zb87/esphome-comfoair/pcb/v1/PCBv1 - Top Case.stl

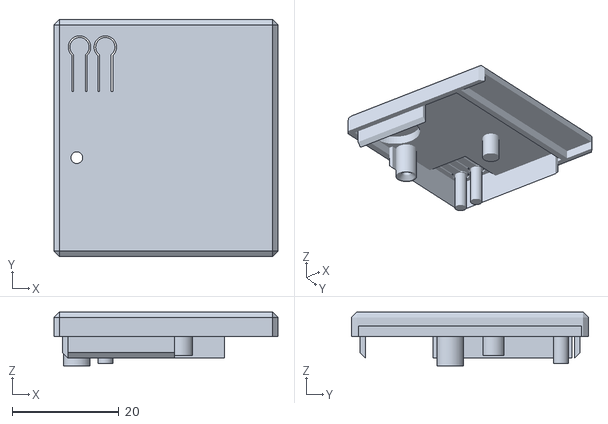
[picture p1: CAD file, 2026-07-18]
pcb/v1/PCBv1 - Top Case.stl
41.9 x 44.4 x 10.1
