zb87/esphome-comfoair/pcb/v1/PCBv1 - Bottom Case.stl

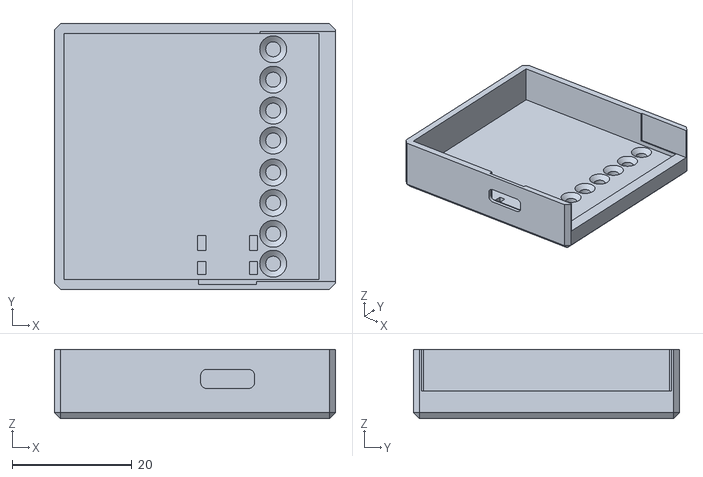
[picture p2: CAD file, 2026-07-18]
pcb/v1/PCBv1 - Bottom Case.stl
46.9 x 44.4 x 11.6
