zb87/esphome-comfoair/pcb/v1/ComfoAir_Schematic_V1.01.pdf

# ESP32 S3

# POWER

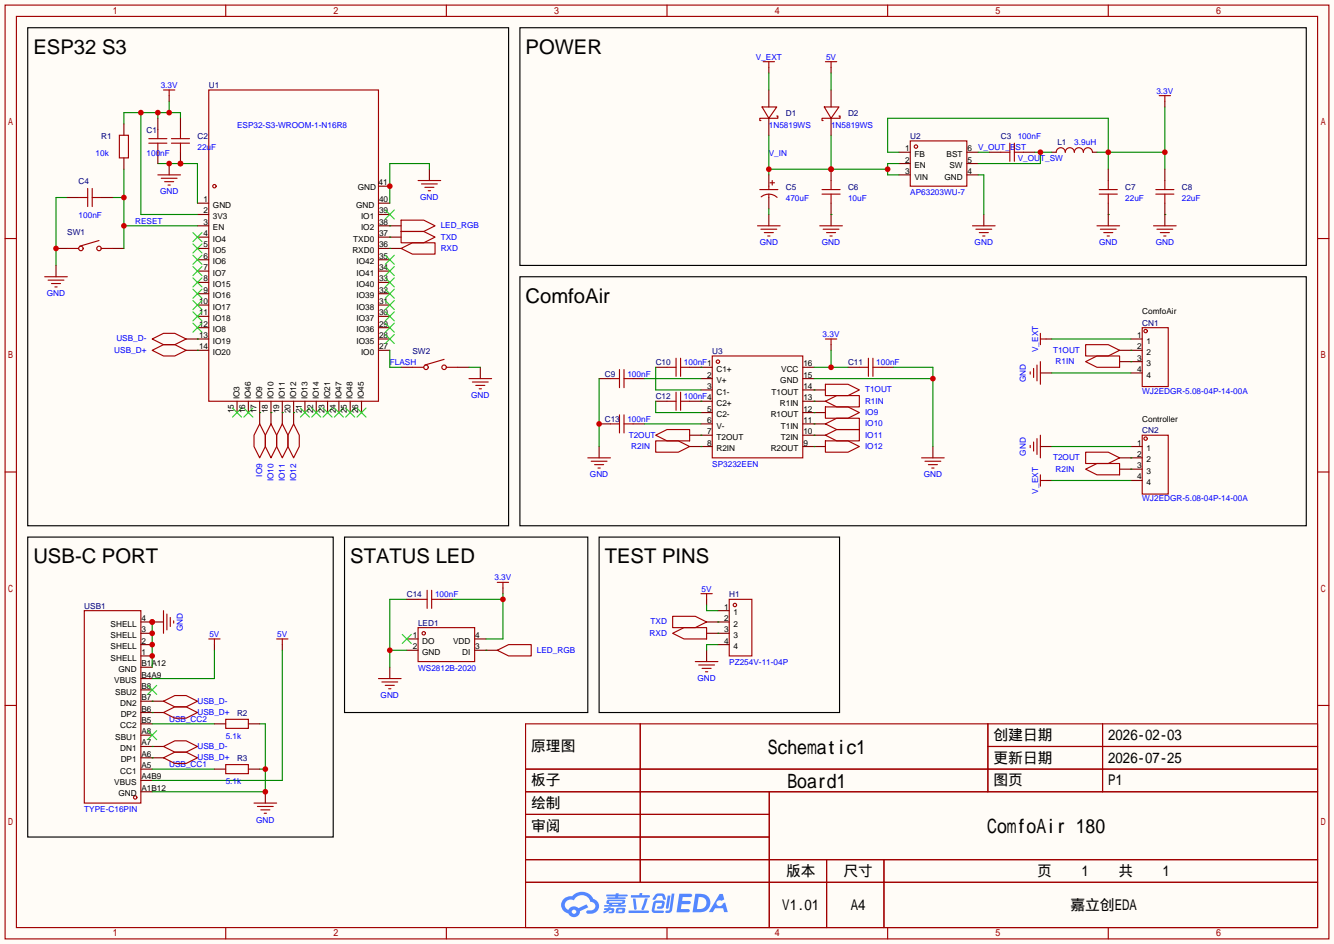
[picture p3: page 1]

GND A1B12 VBUS A4B9 CC1 A5 DP1 A6 DN1 A7 SBU1 A8 CC2 B5 DP2 B6 DN2 B7 SBU2 B8 VBUS B4A9 GND B1A12 SHELL 1

原理图 | Schematic1 | 创建日期 | 2026-02-03

更新日期 | 2026-07-25

板子 | Board1 | 图页 | P1
绘制 | | ComfoAir 180
审阅

V1.01 | A4 | 嘉立创EDA
