zb87/esphome-comfoair/components/comfoair/comfoair.h

#pragma once

#include <deque>
#include <algorithm>
#include "esphome.h"
#include "esphome/core/component.h"
#include "esphome/components/uart/uart.h"
#include "esphome/components/wifi/wifi_component.h"
#include "esphome/components/climate/climate.h"
#include "esphome/components/climate/climate_mode.h"
#include "esphome/components/climate/climate_traits.h"
#include "esphome/components/sensor/sensor.h"
#include "registers.h"

namespace esphome {
namespace comfoair {

struct ComfoAirCommand {
  uint8_t command{0};
  uint8_t data[16]{0};
  uint8_t length{0};
};

static constexpr const char *const TAG = "comfoair";

static const uint8_t COMFOAIR_MIN_SUPPORTED_TEMP = 12;
static const uint8_t COMFOAIR_MAX_SUPPORTED_TEMP = 29;
static const float COMFOAIR_SUPPORTED_TEMP_STEP = 0.5f;

// Temperature and RPM helpers (Item 2.1)
inline float raw_to_celsius(uint8_t raw) { return (float) raw / 2.0f - 20.0f; }
inline uint8_t celsius_to_raw(float temp) { return (uint8_t) ((temp + 20.0f) * 2.0f); }
inline float raw_to_rpm(uint16_t raw) { return raw > 0 ? (1875000.0f / (float) raw) : 0.0f; }

// Protocol & Bitmask Constants (Item 2.3)
constexpr int FAN_LEVEL_AUTO = 0x00;
constexpr int FAN_LEVEL_OFF = 0x01;
constexpr int FAN_LEVEL_LOW = 0x02;
constexpr int FAN_LEVEL_MEDIUM = 0x03;
constexpr int FAN_LEVEL_HIGH = 0x04;

constexpr uint8_t TEMP_FLAG_OUTSIDE = 0x01;
constexpr uint8_t TEMP_FLAG_SUPPLY = 0x02;
constexpr uint8_t TEMP_FLAG_RETURN = 0x04;
constexpr uint8_t TEMP_FLAG_EXHAUST = 0x08;
constexpr uint8_t TEMP_FLAG_EWT = 0x10;
constexpr uint8_t TEMP_FLAG_REHEATING = 0x20;
constexpr uint8_t TEMP_FLAG_KITCHEN_HOOD = 0x40;

constexpr uint8_t STATUS_OPT_FIREPLACE = 0x01;
constexpr uint8_t STATUS_OPT_KITCHEN_HOOD = 0x02;
constexpr uint8_t STATUS_OPT_POSTHEATING = 0x04;
constexpr uint8_t STATUS_OPT_POSTHEATING_PWM = 0x40;

constexpr uint8_t UNIT_TYPE_LEFT = 1;
constexpr uint8_t UNIT_TYPE_RIGHT = 2;

constexpr uint8_t UNIT_SIZE_LARGE = 1;
constexpr uint8_t UNIT_SIZE_SMALL = 2;

class ComfoAirComponent : public climate::Climate, public PollingComponent, public uart::UARTDevice {
public:

  // Poll every 1000ms
  ComfoAirComponent() :
  Climate(),
  PollingComponent(1000),
  UARTDevice() { }

  /// Return the traits of this controller.
  climate::ClimateTraits traits() override {
    auto traits = climate::ClimateTraits();
    traits.add_feature_flags(esphome::climate::CLIMATE_SUPPORTS_CURRENT_TEMPERATURE);
    traits.set_supported_modes({
      climate::CLIMATE_MODE_FAN_ONLY
    });
    traits.clear_feature_flags(esphome::climate::CLIMATE_REQUIRES_TWO_POINT_TARGET_TEMPERATURE);
    traits.set_supported_presets({
      climate::CLIMATE_PRESET_HOME,
    });
    traits.clear_feature_flags(esphome::climate::CLIMATE_SUPPORTS_ACTION);
    traits.set_visual_min_temperature(COMFOAIR_MIN_SUPPORTED_TEMP);
    traits.set_visual_max_temperature(COMFOAIR_MAX_SUPPORTED_TEMP);
    traits.set_visual_temperature_step(COMFOAIR_SUPPORTED_TEMP_STEP);
    traits.set_supported_fan_modes({
      climate::CLIMATE_FAN_LOW,
      climate::CLIMATE_FAN_MEDIUM,
      climate::CLIMATE_FAN_HIGH,
      climate::CLIMATE_FAN_OFF,
    });
    if (enable_fan_auto_) {
      traits.add_supported_fan_mode(climate::CLIMATE_FAN_AUTO);
    }
    return traits;
  }

  /// Override control to change settings of the climate device.
  void control(const climate::ClimateCall &call) override {
    if (call.get_fan_mode().has_value()) {
      int level;

      fan_mode = *call.get_fan_mode();
      switch (fan_mode.value()) {
        case climate::CLIMATE_FAN_HIGH:
          level = FAN_LEVEL_HIGH;
          break;
        case climate::CLIMATE_FAN_MEDIUM:
          level = FAN_LEVEL_MEDIUM;
          break;
        case climate::CLIMATE_FAN_LOW:
          level = FAN_LEVEL_LOW;
          break;
        case climate::CLIMATE_FAN_OFF:
          level = FAN_LEVEL_OFF;
          break;
        case climate::CLIMATE_FAN_AUTO:
          level = FAN_LEVEL_AUTO;
          break;
        case climate::CLIMATE_FAN_ON:
        case climate::CLIMATE_FAN_MIDDLE:
        case climate::CLIMATE_FAN_DIFFUSE:
        default:
          level = -1;
          break;
      }

      if (level >= 0) {
        set_level_(level);
      }

    }
    if (call.get_target_temperature().has_value()) {
      target_temperature = *call.get_target_temperature();
      set_comfort_temperature_(target_temperature);
    }

    publish_state();
    update_counter_ = 0;
  }

  void dump_config() override {
    uint8_t *p;
    ESP_LOGCONFIG(TAG, "ComfoAir:");
    //LOG_UPDATE_INTERVAL(this);
    p = bootloader_version_;
    ESP_LOGCONFIG(TAG, "  Bootloader %.10s v%0d.%02d b%2d", p + 3, *p, *(p + 1), *(p + 2));
    p = firmware_version_;
    ESP_LOGCONFIG(TAG, "  Firmware %.10s v%0d.%02d b%2d", p + 3, *p, *(p + 1), *(p + 2));
    p = connector_board_version_;
    ESP_LOGCONFIG(TAG, "  Connector Board %.10s v%0d.%02d", p + 2, *p, *(p + 1));

    if (*(p + 12) != 0) {
      ESP_LOGCONFIG(TAG, "  CC-Ease v%0d.%02d", *(p + 12) >> 4, *(p + 12) & 0x0f);
    }
    if (*(p + 13) != 0) {
      ESP_LOGCONFIG(TAG, "  CC-Luxe v%0d.%02d", *(p + 13) >> 4, *(p + 13) & 0x0f);
    }
  }

  void update() override {
    // Don't communicate with ComfoAir until WiFi STA is connected.
    // AP mode (fallback hotspot) does not count as connected.
    if (!wifi::global_wifi_component->is_connected()) return;

    if (update_counter_ < 0) {
      // One-time check on start up
      switch(update_counter_) {
        case -4:
          write_command_(CMD_GET_BOOTLOADER_VERSION, nullptr, 0);
          break;
        case -3:
          write_command_(CMD_GET_FIRMWARE_VERSION, nullptr, 0);
          break;
        case -2:
          write_command_(CMD_GET_CONNECTOR_BOARD_VERSION, nullptr, 0);
          break;
        case -1:
          write_command_(CMD_GET_STATUS, nullptr, 0);
          break;
      }
    } else {
      // Periodical check
      switch (update_counter_ % 10) {
        // check every 10 second
        case 0:
          // fan mode, fan on/off
          get_ventilation_level_();
          break;
        case 1:
          get_temperatures_();
          break;
        case 2:
          // fan % level, rpm, etc.
          get_fan_status_();
          break;
        case 3:
          // bypass %, bypass on/off
          if (update_counter_ % 60 < 10) {
            // check once minute
            get_valve_status_();
          }
          break;
        case 4:
          // summer/winter mode
          if (update_counter_ % 3600 < 10) {
            // check once every hour
            get_bypass_control_status_();
          }
          break;
        case 5:
          // filter
          if (update_counter_ % 3600 < 10) {
            // check once every hour
            get_error_status_();
          }
          break;
        case 6:
          if (update_counter_ % 3600 < 10) {
            // check once every hour
            get_operation_hours_();
          }
          break;
        case 7:
          if (update_counter_ % 3600 < 10) {
            // check once every hour
            get_sensor_data_();
          }
          break;
        case 8:
          if (update_counter_ % 3600 < 10) {
            // check once every hour
            get_preheating_status_();
          }
          break;
        case 9:
          if (update_counter_ % 3600 < 10) {
            // check once every hour
            get_time_delay_();
          }
          break;
      }
    }
    
    update_counter_++;
    if (update_counter_ >= 3600) {
      update_counter_ = 0;
    }
  }

  void loop() override {
    // Don't proxy until WiFi STA is connected.
    if (!wifi::global_wifi_component->is_connected()) return;

    // Proxy commands from the display.
    // Read and assemble commands, but only if we don't already have one pending.
    while(uart_proxy_ != nullptr && uart_proxy_->available() != 0 && !proxy_command_ready_) {
      uart_proxy_->read_byte(&proxy_data_[proxy_data_index_]);
      auto check = check_byte_(proxy_data_, proxy_data_index_, proxy_encountered_seven_);
      if (!check.has_value()) {
        // Complete message assembled. Mark ready for sending.
        proxy_command_ready_ = true;
        proxy_command_len_ = proxy_data_index_ + 1;
        proxy_data_index_ = 0;
        proxy_encountered_seven_ = false;
        break;
      } else if (!*check) {
        // wrong data
        ESP_LOGD(TAG, "Byte %i of received data from confosense is invalid.", proxy_data_index_);
        proxy_data_index_ = 0;
        proxy_encountered_seven_ = false;
      } else {
        proxy_data_index_++;
      }
    }

    // Send pending proxy command if available and bus is free.
    if (proxy_command_ready_) {
      bool is_ack = (proxy_data_[COMMAND_ID_ACK] == COMMAND_ACK);
      // ACKs can always be sent immediately (they don't trigger a response).
      // Commands can only be sent when the bus is not busy.
      bool timed_out = (millis() - bus_busy_time_ >= 250);
      if (is_ack || !bus_busy_ || timed_out) {
        if (bus_busy_ && timed_out && !is_ack) {
          ESP_LOGW(TAG, "Bus response timeout, proxying confosense command anyway");
        }
        if (is_ack) {
          ESP_LOGV(TAG, "Proxying ACK from confosense.");
        } else {
          ESP_LOGD(TAG, "Proxying command 0x%02X from confosense with %i bytes.", proxy_data_[COMMAND_IDX_MSG_ID], proxy_command_len_);
          bus_busy_ = true;
          bus_busy_time_ = millis();
        }
        write_array(proxy_data_, proxy_command_len_);
        flush();
        proxy_command_ready_ = false;
      }
    }

    while (available() != 0) {
      read_byte(&data_[data_index_]);
      auto check = check_byte_(data_, data_index_, encountered_seven_);
      if (!check.has_value()) {

        // Response received, bus is free for the next command.
        bus_busy_ = false;

        // finished
        if (data_[COMMAND_ID_ACK] != COMMAND_ACK) {
          parse_data_();
        }

        // Proxy result to the display.
        if (uart_proxy_ != nullptr) {
          if (data_[COMMAND_ID_ACK] == COMMAND_ACK) {
            ESP_LOGV(TAG, "Proxying ACK from comfoair.");
          } else {
            ESP_LOGD(TAG, "Proxying command 0x%02X from comfoair with %i bytes.", data_[COMMAND_IDX_MSG_ID], data_index_+1);
          }
          uart_proxy_->write_array(data_, data_index_+1);
          uart_proxy_->flush();
        }

        data_index_ = 0;
        encountered_seven_ = false;
      } else if (!*check) {
        // wrong data
        ESP_LOGD(TAG, "Byte %i of received data from comfoair is invalid.", data_index_);
        data_index_ = 0;
        encountered_seven_ = false;
      } else {
        // next byte
        data_index_++;
      }
    }

    process_command_queue_();
  }

  float get_setup_priority() const override { return setup_priority::DATA; }

  void error_reset(void) {
    ESP_LOGI(TAG, "Resetting errors");
    uint8_t reset_cmd[4] = {1, 0, 0, 0};
    write_command_(CMD_RESET_AND_SELF_TEST, reset_cmd, sizeof(reset_cmd));
    update_counter_ = 0;
  }

  void filter_reset(void) {
    ESP_LOGI(TAG, "Resetting filter hours");
    uint8_t reset_cmd[4] = {0, 0, 0, 1};
    write_command_(CMD_RESET_AND_SELF_TEST, reset_cmd, sizeof(reset_cmd));
    update_counter_ = 0;
  }

  void configure_fan_levels(
      uint8_t exhaust_level_absent,
      uint8_t exhaust_level_low,
      uint8_t exhaust_level_mid,
      uint8_t exhaust_level_high,
      uint8_t supply_level_absent,
      uint8_t supply_level_low,
      uint8_t supply_level_mid,
      uint8_t supply_level_high
  ) {
    uint8_t command[9] = {
      exhaust_level_absent, 
      exhaust_level_low, 
      exhaust_level_mid, 
      supply_level_absent,
      supply_level_low,
      supply_level_mid,
      exhaust_level_high,
      supply_level_high,
      0
    };
    ESP_LOGW(TAG, "setting ventilation level: %i %i %i %i %i %i %i %i %i", command[0], command[1], command[2], command[3], command[4], command[5], command[6], command[7], command[8]);
    write_command_(CMD_SET_VENTILATION_LEVEL, command, sizeof(command));
  }

  void set_uart_component(uart::UARTComponent *parent) {set_uart_parent(parent);}

  void set_proxy_uart_component(uart::UARTComponent* proxy) {
    if (uart_proxy_ != nullptr) {
      delete uart_proxy_;
    }
    uart_proxy_ = new uart::UARTDevice(proxy);
  }

protected:

  void set_level_(int level) {
    if (level < 0 || level > 4) {
      ESP_LOGI(TAG, "Ignoring invalid level request: %i", level);
      return;
    }

    ESP_LOGI(TAG, "Setting level to: %i", level);
    {
      uint8_t command[1] = {(uint8_t) level};
      write_command_(CMD_SET_LEVEL, command, sizeof(command));
    }
  }

  void set_comfort_temperature_(float temperature) {
    if (temperature < COMFOAIR_MIN_SUPPORTED_TEMP || 
        temperature > COMFOAIR_MAX_SUPPORTED_TEMP) {
      ESP_LOGI(TAG, "Ignoring invalid temperature request: %f", temperature);
      return;
    }

    ESP_LOGI(TAG, "Setting temperature to: %f", temperature);
    {
      uint8_t command[1] = {celsius_to_raw(temperature)};
      write_command_(CMD_SET_COMFORT_TEMPERATURE, command, sizeof(command));
    }
  }

  void write_command_(const uint8_t command, const uint8_t *command_data, uint8_t command_data_length) {
    ComfoAirCommand cmd;
    cmd.command = command;
    cmd.length = (command_data_length > sizeof(cmd.data)) ? sizeof(cmd.data) : command_data_length;
    if (command_data != nullptr && cmd.length > 0) {
      memcpy(cmd.data, command_data, cmd.length);
    }
    command_queue_.push_back(cmd);
    process_command_queue_();
  }

  void process_command_queue_() {
    if (command_queue_.empty()) {
      return;
    }
    if (data_index_ > 0) {
      return;
    }
    uint32_t now = millis();
    if (now - last_command_time_ < 50) {
      return;
    }
    // Don't send commands while the bus is busy (waiting for a response to
    // either a proxied confosense command or our own previous command).
    // This prevents bus collisions where two responses overlap in the serial buffer.
    if (bus_busy_) {
      if (now - bus_busy_time_ < 250) {
        return;
      }
      // Timeout: response was lost, proceed anyway
      ESP_LOGW(TAG, "Bus response timeout, proceeding with own command");
      bus_busy_ = false;
    }
    last_command_time_ = now;

    ComfoAirCommand cmd = command_queue_.front();
    command_queue_.pop_front();

    write_byte(COMMAND_PREFIX);
    write_byte(COMMAND_HEAD);
    write_byte(0x00);
    write_byte(cmd.command);
    write_byte(cmd.length);
    if (cmd.length > 0) {
      for (uint8_t i = 0; i < cmd.length; i++) {
        uint8_t b = cmd.data[i];
        write_byte(b);
        if (b == 0x07) {
          write_byte(0x07);
        }
      }
      write_byte((cmd.command + cmd.length + comfoair_checksum_(cmd.data, cmd.length)) & 0xff);
    } else {
      write_byte(comfoair_checksum_(&cmd.command, 1));
    }
    write_byte(COMMAND_PREFIX);
    write_byte(COMMAND_TAIL);
    flush();

    bus_busy_ = true;
    bus_busy_time_ = millis();
  }

  uint8_t comfoair_checksum_(const uint8_t *command_data, uint8_t length) const {
    uint8_t sum = 0;
    bool last_seven = false;
    for (uint8_t i = 0; i < length; i++) {
      // The checksum counting logic is rather convoluted.
      // It counts all bytes except if two consecutive bytes are
      // 0x07 but only in the data section not in the header.
      if (command_data[i] == 0x07 && i > 2) {
        if (last_seven) {
          last_seven = false;
          continue;
        }
        last_seven = true;
      } else {
        last_seven = false;
      }
      sum += command_data[i];
    }
    return sum + 0xad;
  }

  optional<bool> check_byte_(uint8_t* data, uint8_t &index, bool &encountered_seven) {
    const uint8_t byte = data[index];

    if (index == 0) {
      encountered_seven = false;
      return byte == COMMAND_PREFIX;
    }

    if (index == 1) {
      if (byte == COMMAND_ACK) {
        return {};
      } else {
        return byte == COMMAND_HEAD;
      }
    }

    if (index == 2) {
      return byte == 0x00;
    }

    if (index < COMMAND_LEN_HEAD) {
      return true;
    }

    uint8_t data_length = data[COMMAND_IDX_DATA];

    if ((COMMAND_LEN_HEAD + data_length + COMMAND_LEN_TAIL) > sizeof(data_)) {
      ESP_LOGW(TAG, "ComfoAir message too large");
      return false;
    }

    if (index < COMMAND_LEN_HEAD + data_length) {
      if (byte == 0x07) {
        if (encountered_seven) {
          encountered_seven = false;
          ESP_LOGI(TAG, "Encountered 7 at index %i", index);
          index--;
          return true;
        }
        encountered_seven = true;
      } else {
        encountered_seven = false;
      }
      return true;
    }

    if (index == COMMAND_LEN_HEAD + data_length) {
      // checksum is without checksum bytes
      uint8_t checksum = comfoair_checksum_(data + 2, COMMAND_LEN_HEAD + data_length - 2);
      if (checksum != byte) {
        ESP_LOGW(TAG, "ComfoAir Checksum doesn't match: 0x%02X!=0x%02X", byte, checksum);
        ESP_LOGW(
            TAG,
            "%02X %02X %02X %02X %02X %02X %02X %02X %02X %02X %02X %02X %02X %02X %02X %02X %02X %02X %02X %02X",
            data[0], data[1], data[2], data[3], data[4], data[5], data[6], data[7], data[8], data[9],
            data[10], data[11], data[12], data[13], data[14], data[15], data[16], data[17], data[18], data[19]);
        return false;
      }
      return true;
    }

    if (index == COMMAND_LEN_HEAD + data_length + 1) {
      return byte == COMMAND_PREFIX;
    }

    if (index == COMMAND_LEN_HEAD + data_length + 2) {
      if (byte != COMMAND_TAIL) {
        return false;
      }
    }

    return {};
  }

  // --- Deduplication helpers ---
  // Only publish if the new value differs from the current state (or if no state has been published yet).
  static void publish_if_changed_(sensor::Sensor *s, float value) {
    if (s != nullptr && (!s->has_state() || s->state != value)) {
      s->publish_state(value);
    }
  }
  static void publish_if_changed_(binary_sensor::BinarySensor *s, bool value) {
    if (s != nullptr && (!s->has_state() || s->state != value)) {
      s->publish_state(value);
    }
  }
  static void publish_if_changed_(text_sensor::TextSensor *s, const std::string &value) {
    if (s != nullptr && (!s->has_state() || s->state != value)) {
      s->publish_state(value);
    }
  }

  void parse_version_info_(uint8_t *target, size_t target_size, const uint8_t *msg) {
    size_t len = std::min((size_t) data_[COMMAND_IDX_DATA], target_size - 1);
    memcpy(target, msg, len);
    target[len] = 0;
  }

  void parse_fan_status_(const uint8_t *msg) {
    publish_if_changed_(intake_fan_speed, (float) msg[0]);
    publish_if_changed_(exhaust_fan_speed, (float) msg[1]);
    publish_if_changed_(intake_fan_speed_rpm, raw_to_rpm(get_uint16_(2)));
    publish_if_changed_(exhaust_fan_speed_rpm, raw_to_rpm(get_uint16_(4)));
  }

  void parse_valve_status_(const uint8_t *msg) {
    publish_if_changed_(bypass_valve, (float) msg[0]);
    publish_if_changed_(bypass_valve_open, msg[0] != 0);
    publish_if_changed_(preheating_state, msg[1] != 0);
    publish_if_changed_(motor_current_bypass, (float) msg[2]);
    publish_if_changed_(motor_current_preheating, (float) msg[3]);
  }

  void parse_bypass_control_status_(const uint8_t *msg) {
    publish_if_changed_(bypass_factor, (float) msg[2]);
    publish_if_changed_(bypass_step, (float) msg[3]);
    publish_if_changed_(bypass_correction, (float) msg[4]);
    publish_if_changed_(summer_mode, msg[6] != 0);
  }

  void parse_temperature_status_(const uint8_t *msg) {
    publish_if_changed_(outside_air_temperature, raw_to_celsius(msg[0]));
    publish_if_changed_(supply_air_temperature, raw_to_celsius(msg[1]));
    publish_if_changed_(return_air_temperature, raw_to_celsius(msg[2]));
    publish_if_changed_(exhaust_air_temperature, raw_to_celsius(msg[3]));
  }

  void parse_sensor_data_(const uint8_t *msg) {
    publish_if_changed_(enthalpy_temperature, raw_to_celsius(msg[0]));
  }

  void parse_ventilation_level_(const uint8_t *msg) {
    ESP_LOGD(TAG, "Level %02x", msg[8]);

    publish_if_changed_(return_air_level, (float) msg[6]);
    publish_if_changed_(supply_air_level, (float) msg[7]);
    publish_if_changed_(ventilation_level, (float) (msg[8] - 1));

    climate::ClimateFanMode new_fan_mode = fan_mode.value_or(climate::CLIMATE_FAN_OFF);
    switch (msg[8]) {
      case FAN_LEVEL_AUTO:  new_fan_mode = climate::CLIMATE_FAN_AUTO;   break;
      case FAN_LEVEL_OFF:   new_fan_mode = climate::CLIMATE_FAN_OFF;    break;
      case FAN_LEVEL_LOW:   new_fan_mode = climate::CLIMATE_FAN_LOW;    break;
      case FAN_LEVEL_MEDIUM:new_fan_mode = climate::CLIMATE_FAN_MEDIUM; break;
      case FAN_LEVEL_HIGH:  new_fan_mode = climate::CLIMATE_FAN_HIGH;   break;
    }

    if (fan_mode != new_fan_mode || mode != climate::CLIMATE_MODE_FAN_ONLY) {
      fan_mode = new_fan_mode;
      mode = climate::CLIMATE_MODE_FAN_ONLY;
      publish_state();
    }

    publish_if_changed_(supply_fan_active, msg[9] == 1);
  }

  void parse_faults_(const uint8_t *msg) {
    uint8_t status = msg[8];
    publish_if_changed_(filter_status, std::string(status == 0 ? "Ok" : (status == 1 ? "Full" : "Unknown")));
  }

  void parse_temperatures_(const uint8_t *msg) {
    float new_target = raw_to_celsius(msg[0]);
    bool climate_changed = (target_temperature != new_target);
    target_temperature = new_target;

    if ((msg[5] & TEMP_FLAG_OUTSIDE)) {
      publish_if_changed_(outside_air_temperature, raw_to_celsius(msg[1]));
    }
    if ((msg[5] & TEMP_FLAG_SUPPLY)) {
      publish_if_changed_(supply_air_temperature, raw_to_celsius(msg[2]));
    }
    if ((msg[5] & TEMP_FLAG_RETURN)) {
      float new_current = raw_to_celsius(msg[3]);
      publish_if_changed_(return_air_temperature, new_current);
      if (current_temperature != new_current) {
        current_temperature = new_current;
        climate_changed = true;
      }
    }
    if ((msg[5] & TEMP_FLAG_EXHAUST)) {
      publish_if_changed_(exhaust_air_temperature, raw_to_celsius(msg[4]));
    }
    if ((msg[5] & TEMP_FLAG_EWT)) {
      publish_if_changed_(ewt_temperature, raw_to_celsius(msg[6]));
    }
    if ((msg[5] & TEMP_FLAG_REHEATING)) {
      publish_if_changed_(reheating_temperature, raw_to_celsius(msg[7]));
    }
    if ((msg[5] & TEMP_FLAG_KITCHEN_HOOD)) {
      publish_if_changed_(kitchen_hood_temperature, raw_to_celsius(msg[8]));
    }

    if (climate_changed) {
      publish_state();
    }
  }

  void parse_status_(const uint8_t *msg) {
    publish_if_changed_(preheating_present, (bool) msg[0]);
    publish_if_changed_(bypass_present, (bool) msg[1]);
    publish_if_changed_(type, std::string(msg[2] == UNIT_TYPE_LEFT ? "Left" : (msg[2] == UNIT_TYPE_RIGHT ? "Right" : "Unknown")));
    publish_if_changed_(size, std::string(msg[3] == UNIT_SIZE_LARGE ? "Large" : (msg[3] == UNIT_SIZE_SMALL ? "Small" : "Unknown")));
    publish_if_changed_(options_present, (bool) msg[4]);
    publish_if_changed_(fireplace_present, (bool) (msg[4] & STATUS_OPT_FIREPLACE));
    publish_if_changed_(kitchen_hood_present, (bool) (msg[4] & STATUS_OPT_KITCHEN_HOOD));
    publish_if_changed_(postheating_present, (bool) (msg[4] & STATUS_OPT_POSTHEATING));
    publish_if_changed_(postheating_pwm_mode_present, (bool) (msg[4] & STATUS_OPT_POSTHEATING_PWM));

    publish_if_changed_(p10_active, (bool) (msg[6] & (1 << 0)));
    publish_if_changed_(p11_active, (bool) (msg[6] & (1 << 1)));
    publish_if_changed_(p12_active, (bool) (msg[6] & (1 << 2)));
    publish_if_changed_(p13_active, (bool) (msg[6] & (1 << 3)));
    publish_if_changed_(p14_active, (bool) (msg[6] & (1 << 4)));
    publish_if_changed_(p15_active, (bool) (msg[6] & (1 << 5)));
    publish_if_changed_(p16_active, (bool) (msg[6] & (1 << 6)));
    publish_if_changed_(p17_active, (bool) (msg[6] & (1 << 7)));

    publish_if_changed_(p18_active, (bool) (msg[7] & (1 << 0)));
    publish_if_changed_(p19_active, (bool) (msg[7] & (1 << 1)));

    publish_if_changed_(p90_active, (bool) (msg[8] & (1 << 0)));
    publish_if_changed_(p91_active, (bool) (msg[8] & (1 << 1)));
    publish_if_changed_(p92_active, (bool) (msg[8] & (1 << 2)));
    publish_if_changed_(p93_active, (bool) (msg[8] & (1 << 3)));
    publish_if_changed_(p94_active, (bool) (msg[8] & (1 << 4)));
    publish_if_changed_(p95_active, (bool) (msg[8] & (1 << 5)));
    publish_if_changed_(p96_active, (bool) (msg[8] & (1 << 6)));
    publish_if_changed_(p97_active, (bool) (msg[8] & (1 << 7)));

    publish_if_changed_(enthalpy_present, (bool) msg[9]);
    publish_if_changed_(ewt_present, (bool) msg[10]);
  }

  void parse_operating_hours_(const uint8_t *msg) {
    publish_if_changed_(level0_hours, (float) ((msg[0] << 16) | (msg[1] << 8) | msg[2]));
    publish_if_changed_(level1_hours, (float) ((msg[3] << 16) | (msg[4] << 8) | msg[5]));
    publish_if_changed_(level2_hours, (float) ((msg[6] << 16) | (msg[7] << 8) | msg[8]));
    publish_if_changed_(level3_hours, (float) ((msg[17] << 16) | (msg[18] << 8) | msg[19]));
    publish_if_changed_(frost_protection_hours, (float) ((msg[9] << 8) | msg[10]));
    publish_if_changed_(bypass_open_hours, (float) ((msg[13] << 8) | msg[14]));
    publish_if_changed_(preheating_hours, (float) ((msg[11] << 8) | msg[12]));
    publish_if_changed_(filter_hours, (float) ((msg[15] << 8) | msg[16]));
  }

  void parse_preheating_status_(const uint8_t *msg) {
    std::string valve_state;
    switch (msg[0]) {
      case 0: valve_state = "Closed"; break;
      case 1: valve_state = "Open"; break;
      default: valve_state = "Unknown"; break;
    }
    publish_if_changed_(preheating_valve, valve_state);
    publish_if_changed_(frost_protection_active, msg[1] != 0);
    publish_if_changed_(preheating_state, msg[2] != 0);
    publish_if_changed_(frost_protection_minutes, (float) ((msg[3] << 8) | msg[4]));

    std::string fp_level;
    switch (msg[5]) {
      case 0: fp_level = "GuaranteedProtection"; break;
      case 1: fp_level = "HighProtection"; break;
      case 2: fp_level = "NominalProtection"; break;
      case 3: fp_level = "Economy"; break;
      default: fp_level = "Unknown"; break;
    }
    publish_if_changed_(frost_protection_level, fp_level);
  }

  void parse_time_delay_(const uint8_t *msg) {
    publish_if_changed_(bathroom_switch_on_delay_minutes, (float) msg[0]);
    publish_if_changed_(bathroom_switch_off_delay_minutes, (float) msg[1]);
    publish_if_changed_(l1_switch_off_delay_minutes, (float) msg[2]);
    publish_if_changed_(boost_ventilation_minutes, (float) msg[3]);
    publish_if_changed_(filter_warning_weeks, (float) msg[4]);
    publish_if_changed_(rf_high_time_short_minutes, (float) msg[5]);
    publish_if_changed_(rf_high_time_long_minutes, (float) msg[6]);
    publish_if_changed_(extractor_hood_switch_off_delay_minutes, (float) msg[7]);
  }

  void parse_data_() {
    status_clear_warning();
    uint8_t *msg = &data_[COMMAND_LEN_HEAD];

    switch (data_[COMMAND_IDX_MSG_ID]) {
      case RES_GET_BOOTLOADER_VERSION:
        parse_version_info_(bootloader_version_, sizeof(bootloader_version_), msg);
        break;
      case RES_GET_FIRMWARE_VERSION:
        parse_version_info_(firmware_version_, sizeof(firmware_version_), msg);
        break;
      case RES_GET_CONNECTOR_BOARD_VERSION:
        parse_version_info_(connector_board_version_, sizeof(connector_board_version_), msg);
        break;
      case RES_GET_FAN_STATUS:
        parse_fan_status_(msg);
        break;
      case RES_GET_VALVE_STATUS:
        parse_valve_status_(msg);
        break;
      case RES_GET_BYPASS_CONTROL_STATUS:
        parse_bypass_control_status_(msg);
        break;
      case RES_GET_TEMPERATURE_STATUS:
        parse_temperature_status_(msg);
        break;
      case RES_GET_SENSOR_DATA:
        parse_sensor_data_(msg);
        break;
      case RES_GET_VENTILATION_LEVEL:
        parse_ventilation_level_(msg);
        break;
      case RES_GET_FAULTS:
        parse_faults_(msg);
        break;
      case RES_GET_TEMPERATURES:
        parse_temperatures_(msg);
        break;
      case RES_GET_STATUS:
        parse_status_(msg);
        break;
      case RES_GET_OPERATION_HOURS:
        parse_operating_hours_(msg);
        break;
      case RES_GET_PREHEATING_STATUS:
        parse_preheating_status_(msg);
        break;
      case RES_GET_TIME_DELAY:
        parse_time_delay_(msg);
        break;
    }
  }

  void get_fan_status_() {
    if (intake_fan_speed != nullptr ||
        exhaust_fan_speed != nullptr ||
        intake_fan_speed_rpm != nullptr ||
        exhaust_fan_speed_rpm != nullptr) {
      ESP_LOGD(TAG, "getting fan status");
      write_command_(CMD_GET_FAN_STATUS, nullptr, 0);
    }
  }

  void get_valve_status_() {
    if (bypass_valve != nullptr ||
        bypass_valve_open != nullptr ||
        preheating_state != nullptr) {
      ESP_LOGD(TAG, "getting valve status");
      write_command_(CMD_GET_VALVE_STATUS, nullptr, 0);
    }
  }

  void get_error_status_() {
    if (filter_status != nullptr) {
      ESP_LOGD(TAG, "getting error status");
      write_command_(CMD_GET_FAULTS, nullptr, 0);
    }
  }

  void get_bypass_control_status_() {
    if (bypass_factor != nullptr ||
        bypass_step != nullptr ||
        bypass_correction != nullptr ||
        summer_mode != nullptr) {
      ESP_LOGD(TAG, "getting bypass control");
      write_command_(CMD_GET_BYPASS_CONTROL_STATUS, nullptr, 0);
    }
  }



  void get_sensor_data_() {
    if (enthalpy_temperature != nullptr) {
      ESP_LOGD(TAG, "getting sensor data");
      write_command_(CMD_GET_SENSOR_DATA, nullptr, 0);
    }
  }

  void get_ventilation_level_() {
    ESP_LOGD(TAG, "getting ventilation level");
    write_command_(CMD_GET_VENTILATION_LEVEL, nullptr, 0);
  }

  void get_temperatures_() {
    ESP_LOGD(TAG, "getting temperatures");
    write_command_(CMD_GET_TEMPERATURES, nullptr, 0);
  }

  void get_operation_hours_() {
    ESP_LOGD(TAG, "getting operation hours");
    write_command_(CMD_GET_OPERATION_HOURS, nullptr, 0);
  }

  void get_preheating_status_() {
    ESP_LOGD(TAG, "getting preheating status");
    write_command_(CMD_GET_PREHEATING_STATUS, nullptr, 0);
  }

  void get_time_delay_() {
    ESP_LOGD(TAG, "getting time delay");
    write_command_(CMD_GET_TIME_DELAY, nullptr, 0);
  }

  uint8_t get_uint8_t_(uint8_t start_index) const {
    return data_[COMMAND_LEN_HEAD + start_index];
  }

  uint16_t get_uint16_(uint8_t start_index) const {
    return (uint16_t(data_[COMMAND_LEN_HEAD + start_index + 1] | data_[COMMAND_LEN_HEAD + start_index] << 8));
  }

  uint8_t data_[64];
  uint8_t data_index_{0};
  uint8_t proxy_data_[64];
  uint8_t proxy_data_index_{0};
  bool encountered_seven_{false};
  bool proxy_encountered_seven_{false};
  bool enable_fan_auto_{false};
  int32_t update_counter_{-4};
  std::deque<ComfoAirCommand> command_queue_;
  uint32_t last_command_time_{0};
  bool bus_busy_{false};
  uint32_t bus_busy_time_{0};
  bool proxy_command_ready_{false};
  uint8_t proxy_command_len_{0};

  uint8_t bootloader_version_[13]{0};
  uint8_t firmware_version_[13]{0};
  uint8_t connector_board_version_[14]{0};

  uart::UARTDevice *uart_proxy_{nullptr};

public:
  text_sensor::TextSensor *type{nullptr};
  text_sensor::TextSensor *size{nullptr};
  text_sensor::TextSensor *filter_status{nullptr};
  text_sensor::TextSensor *frost_protection_level{nullptr};
  text_sensor::TextSensor *preheating_valve{nullptr};
  sensor::Sensor *intake_fan_speed{nullptr};
  sensor::Sensor *exhaust_fan_speed{nullptr};
  sensor::Sensor *intake_fan_speed_rpm{nullptr};
  sensor::Sensor *exhaust_fan_speed_rpm{nullptr};
  sensor::Sensor *ventilation_level{nullptr};
  sensor::Sensor *outside_air_temperature{nullptr};
  sensor::Sensor *supply_air_temperature{nullptr};
  sensor::Sensor *return_air_temperature{nullptr};
  sensor::Sensor *exhaust_air_temperature{nullptr};
  sensor::Sensor *enthalpy_temperature{nullptr};
  sensor::Sensor *ewt_temperature{nullptr};
  sensor::Sensor *reheating_temperature{nullptr};
  sensor::Sensor *kitchen_hood_temperature{nullptr};
  sensor::Sensor *return_air_level{nullptr};
  sensor::Sensor *supply_air_level{nullptr};
  sensor::Sensor *bypass_factor{nullptr};
  sensor::Sensor *bypass_step{nullptr};
  sensor::Sensor *bypass_correction{nullptr};
  sensor::Sensor *bypass_open_hours{nullptr};
  sensor::Sensor *motor_current_bypass{nullptr};
  sensor::Sensor *motor_current_preheating{nullptr};
  sensor::Sensor *preheating_hours{nullptr};
  sensor::Sensor *level0_hours{nullptr};
  sensor::Sensor *level1_hours{nullptr};
  sensor::Sensor *level2_hours{nullptr};
  sensor::Sensor *level3_hours{nullptr};
  binary_sensor::BinarySensor *frost_protection_active{nullptr};
  sensor::Sensor *frost_protection_hours{nullptr};
  sensor::Sensor *frost_protection_minutes{nullptr};
  sensor::Sensor *filter_hours{nullptr};
  sensor::Sensor *bypass_valve{nullptr};
  binary_sensor::BinarySensor *bypass_present{nullptr};
  binary_sensor::BinarySensor *enthalpy_present{nullptr};
  binary_sensor::BinarySensor *ewt_present{nullptr};
  binary_sensor::BinarySensor *preheating_present{nullptr};
  binary_sensor::BinarySensor *options_present{nullptr};
  binary_sensor::BinarySensor *fireplace_present{nullptr};
  binary_sensor::BinarySensor *kitchen_hood_present{nullptr};
  binary_sensor::BinarySensor *postheating_present{nullptr};
  binary_sensor::BinarySensor *postheating_pwm_mode_present{nullptr};
  binary_sensor::BinarySensor *bypass_valve_open{nullptr};
  binary_sensor::BinarySensor *preheating_state{nullptr};
  binary_sensor::BinarySensor *summer_mode{nullptr};
  binary_sensor::BinarySensor *supply_fan_active{nullptr};
  binary_sensor::BinarySensor *p10_active{nullptr};
  binary_sensor::BinarySensor *p11_active{nullptr};
  binary_sensor::BinarySensor *p12_active{nullptr};
  binary_sensor::BinarySensor *p13_active{nullptr};
  binary_sensor::BinarySensor *p14_active{nullptr};
  binary_sensor::BinarySensor *p15_active{nullptr};
  binary_sensor::BinarySensor *p16_active{nullptr};
  binary_sensor::BinarySensor *p17_active{nullptr};
  binary_sensor::BinarySensor *p18_active{nullptr};
  binary_sensor::BinarySensor *p19_active{nullptr};
  binary_sensor::BinarySensor *p90_active{nullptr};
  binary_sensor::BinarySensor *p91_active{nullptr};
  binary_sensor::BinarySensor *p92_active{nullptr};
  binary_sensor::BinarySensor *p93_active{nullptr};
  binary_sensor::BinarySensor *p94_active{nullptr};
  binary_sensor::BinarySensor *p95_active{nullptr};
  binary_sensor::BinarySensor *p96_active{nullptr};
  binary_sensor::BinarySensor *p97_active{nullptr};
  sensor::Sensor *bathroom_switch_on_delay_minutes{nullptr};
  sensor::Sensor *bathroom_switch_off_delay_minutes{nullptr};
  sensor::Sensor *l1_switch_off_delay_minutes{nullptr};
  sensor::Sensor *boost_ventilation_minutes{nullptr};
  sensor::Sensor *filter_warning_weeks{nullptr};
  sensor::Sensor *rf_high_time_short_minutes{nullptr};
  sensor::Sensor *rf_high_time_long_minutes{nullptr};
  sensor::Sensor *extractor_hood_switch_off_delay_minutes{nullptr};

  void set_type(text_sensor::TextSensor *type) { this->type = type; };
  void set_size(text_sensor::TextSensor *size) { this->size = size; };
  void set_intake_fan_speed(sensor::Sensor *intake_fan_speed) { this->intake_fan_speed = intake_fan_speed; };
  void set_exhaust_fan_speed(sensor::Sensor *exhaust_fan_speed) { this->exhaust_fan_speed = exhaust_fan_speed; };
  void set_intake_fan_speed_rpm(sensor::Sensor *intake_fan_speed_rpm) { this->intake_fan_speed_rpm = intake_fan_speed_rpm; };
  void set_exhaust_fan_speed_rpm(sensor::Sensor *exhaust_fan_speed_rpm) { this->exhaust_fan_speed_rpm = exhaust_fan_speed_rpm; };
  void set_ventilation_level(sensor::Sensor *ventilation_level) { this->ventilation_level = ventilation_level; };
  void set_bypass_valve(sensor::Sensor *bypass_valve) { this->bypass_valve = bypass_valve; };
  void set_bypass_present(binary_sensor::BinarySensor *bypass_present) { this->bypass_present = bypass_present; };
  void set_enthalpy_present(binary_sensor::BinarySensor *enthalpy_present) { this->enthalpy_present = enthalpy_present; };
  void set_ewt_present(binary_sensor::BinarySensor *ewt_present) { this->ewt_present = ewt_present; };
  void set_preheating_present(binary_sensor::BinarySensor *preheating_present) { this->preheating_present = preheating_present; };
  void set_options_present(binary_sensor::BinarySensor *options_present) { this->options_present = options_present; };
  void set_fireplace_present(binary_sensor::BinarySensor *fireplace_present) { this->fireplace_present = fireplace_present; };
  void set_kitchen_hood_present(binary_sensor::BinarySensor *kitchen_hood_present) { this->kitchen_hood_present = kitchen_hood_present; };
  void set_postheating_present(binary_sensor::BinarySensor *postheating_present) { this->postheating_present = postheating_present; };
  void set_postheating_pwm_mode_present(binary_sensor::BinarySensor *postheating_pwm_mode_present) { this->postheating_pwm_mode_present = postheating_pwm_mode_present; };
  void set_bypass_valve_open(binary_sensor::BinarySensor *bypass_valve_open) { this->bypass_valve_open = bypass_valve_open; };
  void set_preheating_state(binary_sensor::BinarySensor *preheating_state) { this->preheating_state = preheating_state; };
  void set_outside_air_temperature(sensor::Sensor *outside_air_temperature) { this->outside_air_temperature = outside_air_temperature; };
  void set_supply_air_temperature(sensor::Sensor *supply_air_temperature) { this->supply_air_temperature = supply_air_temperature; };
  void set_return_air_temperature(sensor::Sensor *return_air_temperature) { this->return_air_temperature = return_air_temperature; };
  void set_exhaust_air_temperature(sensor::Sensor *exhaust_air_temperature) { this->exhaust_air_temperature = exhaust_air_temperature; };
  void set_enthalpy_temperature(sensor::Sensor *enthalpy_temperature) { this->enthalpy_temperature = enthalpy_temperature; };
  void set_ewt_temperature(sensor::Sensor *ewt_temperature) { this->ewt_temperature = ewt_temperature; };
  void set_reheating_temperature(sensor::Sensor *reheating_temperature) { this->reheating_temperature = reheating_temperature; };
  void set_kitchen_hood_temperature(sensor::Sensor *kitchen_hood_temperature) { this->kitchen_hood_temperature = kitchen_hood_temperature; };
  void set_return_air_level(sensor::Sensor *return_air_level) { this->return_air_level = return_air_level; };
  void set_supply_air_level(sensor::Sensor *supply_air_level) { this->supply_air_level = supply_air_level; };
  void set_supply_fan_active(binary_sensor::BinarySensor *supply_fan_active) { this->supply_fan_active = supply_fan_active; };
  void set_filter_status(text_sensor::TextSensor *filter_status) { this->filter_status = filter_status; };
  void set_bypass_factor(sensor::Sensor *bypass_factor) { this->bypass_factor = bypass_factor; };
  void set_bypass_step(sensor::Sensor *bypass_step) { this->bypass_step = bypass_step; };
  void set_bypass_correction(sensor::Sensor *bypass_correction) { this->bypass_correction = bypass_correction; };
  void set_bypass_open_hours(sensor::Sensor *bypass_open_hours) { this->bypass_open_hours = bypass_open_hours; };
  void set_motor_current_bypass(sensor::Sensor *motor_current_bypass) { this->motor_current_bypass = motor_current_bypass; };
  void set_motor_current_preheating(sensor::Sensor *motor_current_preheating) { this->motor_current_preheating = motor_current_preheating; };
  void set_preheating_hours(sensor::Sensor *preheating_hours) { this->preheating_hours = preheating_hours; };
  void set_preheating_valve(text_sensor::TextSensor *preheating_valve) { this->preheating_valve = preheating_valve; };
  void set_level0_hours(sensor::Sensor *level0_hours) { this->level0_hours = level0_hours; };
  void set_level1_hours(sensor::Sensor *level1_hours) { this->level1_hours = level1_hours; };
  void set_level2_hours(sensor::Sensor *level2_hours) { this->level2_hours = level2_hours; };
  void set_level3_hours(sensor::Sensor *level3_hours) { this->level3_hours = level3_hours; };
  void set_frost_protection_active(binary_sensor::BinarySensor *frost_protection_active) { this->frost_protection_active = frost_protection_active; };
  void set_frost_protection_hours(sensor::Sensor *frost_protection_hours) { this->frost_protection_hours = frost_protection_hours; };
  void set_frost_protection_minutes(sensor::Sensor *frost_protection_minutes) { this->frost_protection_minutes = frost_protection_minutes; };
  void set_frost_protection_level(text_sensor::TextSensor *frost_protection_level) { this->frost_protection_level = frost_protection_level; };
  void set_filter_hours(sensor::Sensor *filter_hours) { this->filter_hours = filter_hours; };
  void set_summer_mode(binary_sensor::BinarySensor *summer_mode) { this->summer_mode = summer_mode; };
  void set_p10_active(binary_sensor::BinarySensor *p10_active) { this->p10_active = p10_active; };
  void set_p11_active(binary_sensor::BinarySensor *p11_active) { this->p11_active = p11_active; };
  void set_p12_active(binary_sensor::BinarySensor *p12_active) { this->p12_active = p12_active; };
  void set_p13_active(binary_sensor::BinarySensor *p13_active) { this->p13_active = p13_active; };
  void set_p14_active(binary_sensor::BinarySensor *p14_active) { this->p14_active = p14_active; };
  void set_p15_active(binary_sensor::BinarySensor *p15_active) { this->p15_active = p15_active; };
  void set_p16_active(binary_sensor::BinarySensor *p16_active) { this->p16_active = p16_active; };
  void set_p17_active(binary_sensor::BinarySensor *p17_active) { this->p17_active = p17_active; };
  void set_p18_active(binary_sensor::BinarySensor *p18_active) { this->p18_active = p18_active; };
  void set_p19_active(binary_sensor::BinarySensor *p19_active) { this->p19_active = p19_active; };
  void set_p90_active(binary_sensor::BinarySensor *p90_active) { this->p90_active = p90_active; };
  void set_p91_active(binary_sensor::BinarySensor *p91_active) { this->p91_active = p91_active; };
  void set_p92_active(binary_sensor::BinarySensor *p92_active) { this->p92_active = p92_active; };
  void set_p93_active(binary_sensor::BinarySensor *p93_active) { this->p93_active = p93_active; };
  void set_p94_active(binary_sensor::BinarySensor *p94_active) { this->p94_active = p94_active; };
  void set_p95_active(binary_sensor::BinarySensor *p95_active) { this->p95_active = p95_active; };
  void set_p96_active(binary_sensor::BinarySensor *p96_active) { this->p96_active = p96_active; };
  void set_p97_active(binary_sensor::BinarySensor *p97_active) { this->p97_active = p97_active; };
  void set_bathroom_switch_on_delay_minutes(sensor::Sensor *bathroom_switch_on_delay_minutes) { this->bathroom_switch_on_delay_minutes = bathroom_switch_on_delay_minutes; };
  void set_bathroom_switch_off_delay_minutes(sensor::Sensor *bathroom_switch_off_delay_minutes) { this->bathroom_switch_off_delay_minutes = bathroom_switch_off_delay_minutes; };
  void set_l1_switch_off_delay_minutes(sensor::Sensor *l1_switch_off_delay_minutes) { this->l1_switch_off_delay_minutes = l1_switch_off_delay_minutes; };
  void set_boost_ventilation_minutes(sensor::Sensor *boost_ventilation_minutes) { this->boost_ventilation_minutes = boost_ventilation_minutes; };
  void set_filter_warning_weeks(sensor::Sensor *filter_warning_weeks) { this->filter_warning_weeks = filter_warning_weeks; };
  void set_rf_high_time_short_minutes(sensor::Sensor *rf_high_time_short_minutes) { this->rf_high_time_short_minutes = rf_high_time_short_minutes; };
  void set_rf_high_time_long_minutes(sensor::Sensor *rf_high_time_long_minutes) { this->rf_high_time_long_minutes = rf_high_time_long_minutes; };
  void set_extractor_hood_switch_off_delay_minutes(sensor::Sensor *extractor_hood_switch_off_delay_minutes) { this->extractor_hood_switch_off_delay_minutes = extractor_hood_switch_off_delay_minutes; };
  void set_enable_fan_auto(bool enable) { this->enable_fan_auto_ = enable; };
};

}  // namespace comfoair
}  // namespace esphome
