zb87/esphome-comfoair/(commit log)

2026-07-19 fix: clamp memcpy lengths and correct polling comment
    - Clamp version string memcpy() lengths to buffer size - 1 and
    null-terminate to prevent a potential buffer overflow when the
    device reports an unexpectedly large data length field
    (bootloader_version_[13], firmware_version_[13],
    connector_board_version_[14]).
    - Fix stale comment 'Poll every 600ms' to match the actual
    PollingComponent(1000) constructor argument (1000 ms).
    [comfoair.h]
2026-07-19 refactor(config): implement YAML refactoring suggestions (4.1-4.4)
    - 4.1: Parameterize timezone substitution in base.yaml
    - 4.2: Move unused commented sensor definitions to comfoair-all-sensors.yaml.example
    - 4.3: Remove duplicate PSRAM mode setting in esp32-s3-n16r8.yaml
    - 4.4: Extract LED and boot button logic from comfoair.yaml to config/led-status.yaml
2026-07-19 refactor(comfoair): extract conversion helpers, decompose parse_data_, and eliminate magic numbers
    - Extract temperature and RPM conversion helpers in comfoair.h
    - Decompose parse_data_ into dedicated parser methods
    - Replace raw hex constants and bitmasks with named constexpr constants
    - DRY up sensor schema declarations in __init__.py using factory functions
    [comfoair.h]
2026-07-19 refactor(config): separate boot button logic and encapsulate LED status triggers
    - Move boot_button binary sensor back to comfoair.yaml from led-status.yaml
    - Move on_boot and wifi triggers to config/led-status.yaml
    - Rename indicate_fan_level script to generic indicate_level
2026-07-19 fix: add trailing newlines and use bit-shift for P-parameter bitmasks
    [comfoair.h]
2026-07-19 fix: remove dead get_temperature_() with duplicate null-check bug, add enable_fan_auto YAML config option
    - Remove get_temperature_() which was never called (update() uses
    get_temperatures_() instead) and contained a bug where
    outside_air_temperature was checked twice instead of
    exhaust_air_temperature. Bug inherited from both upstream forks.
    - Add enable_fan_auto optional boolean config (default: false) to
    expose CLIMATE_FAN_AUTO mode from YAML rather than requiring a
    C++ code change.
    - Document enable_fan_auto in comfoair-all-sensors.yaml.example.
    [comfoair.h]
2026-07-21 fix(comfoair): isolate 0x07 byte escaping between main and proxy UART streams
    - Add separate proxy_encountered_seven_ flag for display proxy UART stream
    - Pass encountered_seven state by reference to check_byte_
    - Reset encountered_seven state on new frame start and index reset to 0
    [comfoair.h]
2026-07-21 fix(comfoair): add command queueing, UART transmission protection, and 0x07 byte escaping
    [comfoair.h]
2026-07-21 fix(comfoair): expand data buffers, update counter type to int32_t, fix static TAG
    [comfoair.h]
2026-07-21 Fix checksum mismatch caused by bus collision between proxy and own commands
    When the confosense display sends a command to the ComfoAir, the ESP
    would sometimes send its own polling command before the response arrived.
    This caused two responses to overlap in the serial buffer, leading to
    checksum mismatches and parse errors.
    Track proxy state with a flag that prevents sending own commands while a
    confosense command/response cycle is in-flight, with a 250ms timeout
    fallback in case a response is lost.
    [comfoair.h]
2026-07-21 Fix bidirectional bus collision between proxy and own commands
    The previous fix only prevented the ESP from sending while a confosense
    response was pending. But collisions also happen the other way: confosense
    commands get proxied while the ESP is waiting for its own response.
    Replace the unidirectional proxy_awaiting_response_ flag with a single
    bus_busy_ flag that prevents ANY command (own or proxied) from being sent
    while waiting for ANY response. Assembled confosense commands are now
    buffered in proxy_data_ until the bus is free, rather than being forwarded
    immediately.
    [comfoair.h]
2026-07-21 feat: defer ComfoAir communication until WiFi STA is connected
    Skip all UART polling and proxy forwarding in update() and loop()
    until the WiFi station connection is established. AP mode (fallback
    hotspot) is not considered connected, so the component stays idle
    during captive portal / initial boot.
    [comfoair.h]
2026-07-21 fix: deduplicate filter_status publish to stop repeated LED off logs
    The Confosense display polls faults (0xD9/0xDA) every ~1.3s on the
    shared bus. parse_faults_() was calling publish_state() unconditionally,
    re-publishing 'Ok' each time. This triggered the on_value callback,
    which ran show_led_status, which turned off the already-off LED —
    producing noisy '[S][light]: RGB Status LED >> OFF' log spam.
    Now only publishes when the value actually changes.
    [comfoair.h]
2026-07-21 fix(led): use explicit repeat loop for level indicator flashing
    Replace the pulse effect + delay approach with an explicit repeat loop
    that deterministically flashes the LED the correct number of times.
    - Use direct light calls with set_publish(false) and set_save(false)
    to avoid flooding Home Assistant history with rapid state changes
    - Use transition_length(0) for instant on/off without fading
    - Add 200ms lead-in pause for a clean visual start
    [led-status.yaml]
2026-07-21 fix: deduplicate all sensor publish calls to reduce log noise
    The Confosense display continuously polls the ComfoAir on the shared
    bus (~1.3s cycle). The ESP intercepts every response and was
    unconditionally re-publishing all sensor values even when unchanged.
    This caused excessive [S] state logs and unnecessary HA updates.
    Added publish_if_changed_() helper overloads for sensor, binary_sensor,
    and text_sensor that skip publishing when the value matches the current
    state. Also deduplicated climate::publish_state() in parse_temperatures_
    and parse_ventilation_level_ to only publish when target/current temp or
    fan mode actually changes.
    [comfoair.h]
2026-07-25 update pcb files
2026-08-07 feat: add fan boost functionality and PTX YK1 button integration
2026-08-07 fix: more reliable fan boost state machine
2026-08-09 feat: add PTX YK1 Xiaomi button support with event handling and configuration
2026-08-09 feat: update scan parameters for esp32_ble_tracker for better bluetooth proxy performance
2026-08-09 feat: add wireguard support to esphome devices
2026-08-09 bug fix: sensor state doesn't change from unknown to off
2026-10-11 fix: resolve device class and unit mismatches for fan and valve sensors
2026-10-11 comfoair: migrate check_uart_settings to python final validation
    Replace the deprecated C++ `check_uart_settings(9600)` in `ComfoAirComponent::dump_config()`
    with `uart.final_validate_device_schema` in Python via `FINAL_VALIDATE_SCHEMA`.
    Validates baud rate and RX/TX requirements for both main and proxy UART buses.
